Quetrix/Robot_Movil_Autonomo/(commit log)

2026-10-12 Creacion de repositorio.
    Archivos base PlatformIO para ESP32 Dev Module.
    Folder de Datasheets.
    Folder de Enunciados.
2026-11-07 Reorganiza repositorio y documenta locomocion y percepcion
    - Elimina plantilla PlatformIO vacia del root.
    - Avance_1_Locomocion: version principal reconstruida y verificada contra
    respaldo_robot.bin (pines, calibraciones, ganancias, mensajes), binario
    de respaldo e historial de versiones previas.
    - Avance_2_Percepcion: firmware MG996 + Sharp + TF-Luna.
    - READMEs con funcionamiento, pinout, parametros y pendientes.
    - Carpeta Tarea_Integracion para la tarea conjunta.
    Claude-Session: https://claude.ai/code/session_01HvTDYQw96QUSHw9KVsCnTD
2026-11-10 Tarea 8: comportamientos de Braitenberg en la Raspberry Pi
    Maquina de estados base con vehiculos 2a, 2b, 3a y 3b usando los Sharp
    de percepcion (DETAIL) y el comando V de locomocion.
    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
2026-11-10 Tarea 8: lectura del cabezal por WiFi (SoftAP del ESP32)
    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
2026-11-10 Locomocion: variante sin IR con modos de prueba y pinout actualizado
    - locomocion_esp32_sin_IR: sin KY-032, canales RL/RR y signo de FL
    segun el cableado actual, comandos temporizados (W/S/A/D ms,
    V ... ms) y comando H con timeout de 300 ms para mantener teclas.
    - teleop_locomocion.py: control con teclas mantenidas o consola.
    - README: pinout verificado, mapa de drivers, conector del motor y
    alimentacion.
    Claude-Session: https://claude.ai/code/session_01HvTDYU3Myn927VkEMRJzqG
2026-11-10 Agregar enunciado de la Tarea 8
    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
2026-11-10 Locomocion: variante con IR frontal KY-032 en GPIO34
    Copia de locomocion_esp32_sin_IR con un solo agregado: KY-032 frontal
    en GPIO34 (activo en LOW, debounce 20 ms / 60 ms). Mientras detecta se
    anula vy > 0 en V, H y W; S, A, D, R, vx y omega siguen permitidos. Si
    iba avanzando, frenado controlado con el PI o sigue solo la parte
    lateral/giro. Mensajes '# IR FRENTE: OBSTACULO/LIBRE' y columna irF en
    el CSV. Pines, signos, CPR, ganancias y feedforward sin cambios.
    Incluye prueba de la logica en la PC (pruebas_pc/, stub de Arduino) y
    la tabla de pinout del README actualizada.
    Claude-Session: https://claude.ai/code/session_01HvTDYQwMFAJcq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
2026-11-10 Tarea 8: braitenberg.py con H a 10 Hz, regla del TF y panel; simulador
    - mover() envia 'H 0 v w' a 10 Hz: si el script, la Pi o el USB fallan
    el ESP32 frena solo a los 300 ms (antes 'V' a 5 Hz).
    - TF-Luna < 250 mm (o 'menos de 20 cm') anula el avance, con histeresis
    hasta 350 mm. En 2a y 3b, ademas, gira en el lugar hacia el lado mas
    libre (los Sharp a +-60 grados no ven lo que esta al frente).
    - Sharp por debajo de 100 mm (fuera de rango con voltaje alto) cuenta
    como estimulo 1 en vez de 0.
    - Lee los mensajes '# IR FRENTE' y la columna irF del firmware
    ir_frontal; avisa si el ESP32 tiene un firmware sin IR.
    - Frescura de percepcion por numero de captura (seq): 1 s sin capturas
    n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
2026-11-10 Tarea 8: guia de armado, conexion y puesta en marcha; --invertir-sharp
    README de Tarea_Integracion reescrito para el estado actual (firmware
    locomocion_esp32_ir_frontal): funcionamiento y capa de seguridad,
    armado fisico, alimentacion y GND comun, pinout de locomocion y del
    cabezal, revision con multimetro, flasheo, configuracion de la Pi
    (apt, dialout, perfil WiFi del cabezal con IP fija 192.168.4.200),
    encendido, ejecucion, respaldos si el softAP no reenvia entre clientes,
    checklist en banco y en el suelo, tabla de fallas y limitaciones
    (zonas ciegas entre 0 y +-60 grados).
    braitenberg.py: opcion --invertir-sharp para corregir en el lugar
    Sharp izquierdo/derecho intercambiados (con prueba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
2026-11-10 Tarea 8: guion del video y correccion del cambio de red en el README
    guion_video.md: preparacion, 9 tomas en ~4 min, explicacion del codigo
    (maquina de estados, estimulo normalizado, conexiones directa/cruzada y
    excitatoria/inhibitoria, diferencial virtual -> H, capa de seguridad),
    narracion de cada vehiculo, respuesta a la pregunta 4 y que hacer si
    algo falla durante la grabacion.
    README: 'sudo -v' y 'nmcli con up' en lineas separadas (con '&&' bash
    mandaba ambos al fondo y sudo no podia pedir la clave).
    Claude-Session: https://claude.ai/code/session_01HvTDYQwMFAJcqoNgzvS7tu
2026-11-10 Tarea 8: guia paso a paso y scripts revisar.sh / correr.sh
    GUIA_PASO_A_PASO.md: como saber en que terminal y carpeta se esta,
    subir el bundle a GitHub desde PowerShell, conexiones entre la Pi, los
    dos ESP32 y la laptop (cable por cable), flasheo, y cada comando de la
    Pi con lo que se debe ver y que hacer si no sale.
    revisar.sh: diagnostico de la Pi. correr.sh: arranca braitenberg.py
    buscando solo el puerto del ESP32 y guarda el registro CSV.
    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
2026-11-10 braitenberg.py: tope de 0.25 m/s, frenado progresivo por TF y giro minimo
    Prueba en el robot: en 2a avanzo a 0.33 m/s y con el TF en 301 mm
    (umbral 250) no alcanzo a frenar. Ahora:
    - tope de avance V_MAX = 0.25 m/s;
    - entre 600 y 300 mm del TF el avance baja linealmente a 0; si queda
    por debajo de 0.04 m/s se trata como bloqueo;
    - bloqueo por TF a 300 mm (antes 250), se libera a 400 mm (antes 350);
    - en 2a/3b el giro en el lugar dura al menos 1.2 s (~70 grados): antes
    se soltaba apenas el obstaculo salia del rayo del TF y el robot lo
    rozaba con la esquina (fallo de '3b obstaculo al frente').
    Claude-Session: https://claude.ai/code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
2026-11-10 Tarea 8: coreografia.py, movimiento pregrabado de respaldo (sin sensores)
    Perfiles fijos de estimulo sI(t), sD(t) pasados por las mismas funciones
    de los vehiculos y enviados con H a 10 Hz. El panel indica siempre que
    es una trayectoria pregrabada y no el modo autonomo. --espejo pone el
    obstaculo supuesto a la derecha. En el simulador, dos corridas de cada
    vehiculo terminan en la misma pose (< 1 cm).
    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
